nagyizee/flightlogger/Doc/Antenna/100pcs-lot-bluetooth-serial-module-with-Built-in-2-4GHz-PCB-Antennas.jpg

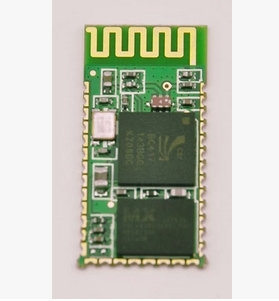
Doc/Antenna/100pcs-lot-bluetooth-serial-module-with-Built-in-2-4GHz-PCB-Antennas.jpg
