nagyizee/flightlogger/Doc/Antenna/Programming-nRF51822-RF-BM-ND02C-PCB-Antenna.jpg_350x350.jpg

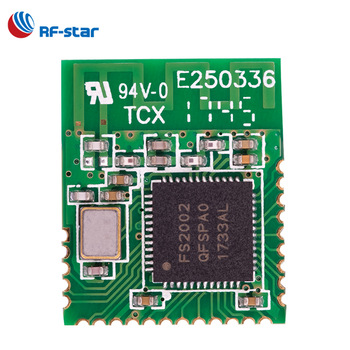
Doc/Antenna/Programming-nRF51822-RF-BM-ND02C-PCB-Antenna.jpg_350x350.jpg
