nagyizee/flightlogger/Doc/Antenna/anntennaPCBtop.PNG

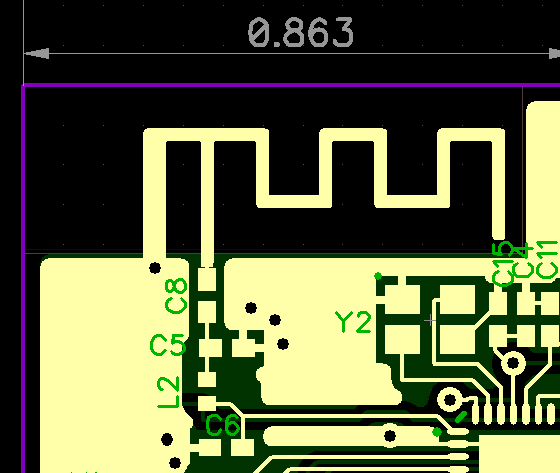
Doc/Antenna/anntennaPCBtop.PNG
