nagyizee/flightlogger/Doc/Antenna/antena_sample.jpg

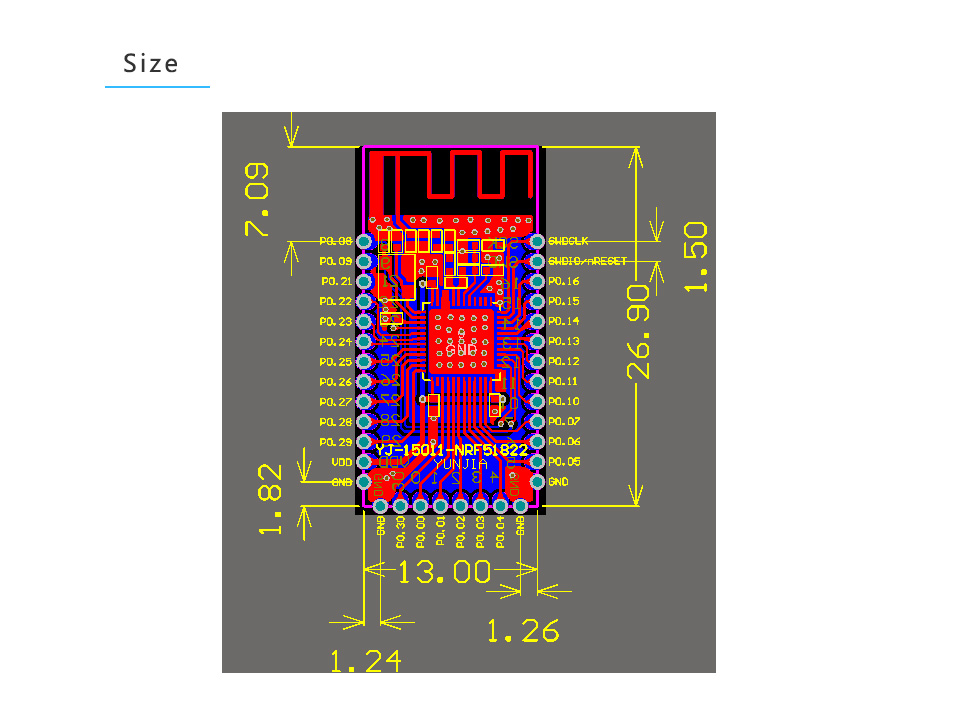
Doc/Antenna/antena_sample.jpg
