nagyizee/flightlogger/Doc/Antenna/images.png

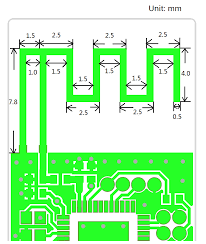
Doc/Antenna/images.png
