nagyizee/flightlogger/Doc/FlightLogger_BOM.xlsx

Designator | Comment | Part name | Description | Footprint | LibRef | Quantity | Price | Total | Location
U1 | nRF52832-QFAA-R7 | nRF52832-QFAA-R7 | ARM Cortex M4 microcontroller with 2.4GHz radio | QFN48 | nRF52832 | 1 | 27.846 | 27.846 | B1P1S15
U2 | XC9264B75DER-G | XC9264B75DER-G | 18V 0.5A step down DC-DC converter | USP-6C | XC9264 | 1 | 5.355 | 5.355 | B1P4S18 | o
U3 | MPL3115A2 | MPL3115A2 | Precision barometer sensor I2C | MPL3115A2 | MPL3115A2 | 1 | 24.871 | 24.871 | B1P2S20 | o
U4 | MMA8452Q | MMA8452Q | 3 axis accelerometer | QFN16SP | MMA8452Q | 1 | 12.257 | 12.257 | B1P2S25 | o
U5 | S25FL064LABNFV040 | S25FL064LABNFV040 | 64Mbit NOR flash | USON8 | S25FL064L | 1 | 5.831 | 5.831 | B1P3S23 | o
D23 | CDZVT2R3.0B | CDZVT2R3.0B | Zener Diode | VMN2M | D Zener | 1 | 0.7854 | 0.7854 | B1P5S21 | o
D10 | LL-S192VC-V1-2B | LL-S192VC-V1-2B | Red LED | 0603_led_red | LED | 1 | 0.5 | 0.5 | B1P7S3
D11 | IN-S63AT5G | IN-S63AT5G | Green LED | 0603_led_green | LED | 1 | 0.476 | 0.476 | B1P7S20
D20, D21, D22 | PMEG2002AESF | PMEG2002AESF | Schottky Barrier Diode | SOD962_2 | 1PS76SB10 | 3 | 1.309 | 3.927 | B1P5S20 | o
Y1 | NX2016SA-32M-EXS00A-CS06465 | NX2016SA-32M-EXS00A-CS06465 | Crystal Oscillator | Cristal_2_1.6_4pin | XTAL | 1 | 2.499 | 2.499 | B1P6S12 | o
C10, C11 | 12p |  | Capacitor | 0402_cap | CAP | 2 | 0.1 | 0.2 | B2P1S1 | o
C12, C13, C15, C21, C25, C30, C31, C40, C41, C51 | 100n |  | Capacitor | 0402_cap | CAP | 10 | 0.1 | 1 | B2P1S15 | o
C14, C32, C42 | 4u7 |  | Capacitor | 0402_cap | CAP | 3 | 0.2 | 0.6 | B2P1S21 | o
C16 | 1u |  | Capacitor | 0402_cap | CAP | 1 | 0.1 | 0.1 | B2P1S18 | o
C17 | 100p |  | Capacitor | 0402_cap | CAP | 1 | 0.1 | 0.1 | B2P1S31 | o
C18 | N/C |  | Capacitor | 0402_cap | CAP | 1 | 0 | 0 | n/a | n
C19 | 0.8p |  | Capacitor | 0402_cap | CAP | 1 | 0.5 | 0.5 | B2P1S34 | o
C20 | 1.2p |  | Capacitor | 0402_cap | CAP | 1 | 0.4 | 0.4 | B2P1S30 | o
C22 | 330p |  | Capacitor | 0402_cap | CAP | 1 | 0.4 | 0.4 | B2P1S32 | o
C23, C24, C50 | 10u | GRM155R60G106ME44J | Capacitor | 0402_cap | CAP | 3 | 0.5 | 1.5 | B2P1S28 | o
C26 | 10n | 885012205067 | Capacitor | 0402_cap | CAP | 1 | 0.1 | 0.1 | B2P1S29 | o
C27, C28 | 100u | GRM31CR61A107ME05L | Capacitor | 1206_cap | CAP | 2 | 2.9 | 5.8 | B2P1S33 | o
L1 | 3.9nH | L-07W3N9JV4T | Inductor | 0402_res | Inductor | 1 | 1.071 | 1.071 | B2P1S55 | o
L20 | 2.2uH | MAMK2520H2R2M | Inductor | 1008_Inductor | Inductor | 1 | 1 | 1 | B2P1S54 | o
R10, R11, R12 | 120 |  | Resistor | 0402_res | RES | 3 | 0.1 | 0.3 | B2P2S12 | o
R13, R14 | 1k |  | Resistor | 0402_res | RES | 2 | 0.1 | 0.2 | B2P2S17 | o
R20, R28 | 100k |  | Resistor | 0402_res | RES | 2 | 0.1 | 0.2 | B2P2S34 | o
R21 | 33k |  | Resistor | 0402_res | RES | 1 | 0.1 | 0.1 | B2P2S27 | o
R22, R24, R50 | 47k |  | Resistor | 0402_res | RES | 3 | 0.1 | 0.3 | B2P2S28 | o
R23 | 6k8 |  | Resistor | 0402_res | RES | 1 | 0.1 | 0.1 | B2P2S22 | o
R25 | 22k |  | Resistor | 0402_res | RES | 1 | 0.1 | 0.1 | B2P2S24 | o
R26 | 2R2 |  | Resistor | 0603_res | RES | 1 | 0.1 | 0.1 | B2P2S5 | o
R27, R30, R31 | 4k7 |  | Resistor | 0402_res | RES | 3 | 0.1 | 0.3 | B2P2S21 | o
R32 | 0 |  | Resistor | 0402_res | RES | 1 | 0.1 | 0.1 | B2P2S1 | o
J1, J2, J3, J4, J10, J11, J12, J13 | PAD |  | Pad | PAD_0.6x1mm | PAD | 8 | 0 | 0 | n/a
P1 | Conn3 |  | 3pin connection | HDR1X3 | conn_3pin_1 | 1 | 0 | 0 | n/a
P2 | Conn4 |  | 4pin connection | conn_4pin_1row_1mm | conn_4pin | 1 | 0 | 0 | n/a
 |  |  |  |  |  |  | Total | 98.9184
