nagyizee/flightlogger/Doc/to_get.xlsx

 |  |  |  |  |  |  | price | pcs. | total | total TVA
XC9264B75DER-G | Switching Voltage Regulators 18V DCDC Converters 0.5A Sync PWM w/AS | in.v 3 - 18V | out.v 1 - 15V | 2.2MHz | 500mA |  | 4.45 | 10 | 44.5 | 52.955 | ok
BD9G101G-TR | Switching Voltage Regulator | in. v 6 - 42V | out. v 1 - 36V | 1.5MHz | 500mA | ssop6
MLZ1608A2R2MT | Fixed Inductors 0603 2.2uH 20% | pack. 603 | 2.2uH | 500mA | 250mOhm |  | 0.42 | 50 | 21 | 24.99
MAMK2520H2R2M | Fixed Inductors 1008 2.2uH 20% | pack. 1008 | 2.2uH | 2.2A | 90mOhm |  | 0.81 | 15 | 12.15 | 14.4585 | ok
1235AS-H-6R8M | Fixed Inductors 4.5x4.7x1.8mm 6u8
AD8418BRMZ-RL | Current Sense Amplifiers 0-Drift Precision Current Sense AMP | 0 - 70V cmV | Vcc 2.7-5.5V | 20x gain | Hi/Lo sense |  | 10.55 | 5 | 52.75 | 62.7725
WSL36371L000DEA | Current Sense Resistors - SMD 3watt .001ohms .5% | 9x9mm |  |  |  |  | 12.3 | 3 | 36.9 | 43.911
BSS84P H6327 | MOSFET P-Ch -60V -170mA SOT-23-3 | 190mA | 60V DS.bkdn. | 20v Gs | 8 Ohm |  | 0.97 | 30 | 29.1 | 34.629
IN-S63AT5G | Standard LEDs - SMD True Green LED | pack. 603 | 350mcd | 3V | 5mA |  | 0.39 | 50 | 19.5 | 23.205 | ok
SS16HE | Schottky Diodes & Rectifiers 60V 1A Schottky Barrier Rectifier | If 1A | Vf 0.4-06V | Vr 60V |  |  | 0.34 | 20 | 6.8 | 8.092
PMEG2002AESF,315 | Schottky Diodes & Rectifiers 20 V, 0.2 A low VF MEGA Schottky | If 200mA | Vf 0.24V | Vr 20V | 10pF | ultra small | 0.98 | 20 | 19.6 | 23.324 | ok
CDZVT2R3.0B | Zener diode 3.0V 1.4x0.5mm |  |  |  |  |  | 0.28 | 100 | 28 | 33.32 | ok
NX2016SA-32M-EXS00A-CS06465 | 32MHz 10ppM prec. / 30ppM stab. 2x1.6x0.5mm | 32MHz | 10pF |  |  |  | 2.04 | 10 | 20.4 | 24.276 | ok
GRM31CR61A107ME05L | 100uF 10V ceramic capacitor | 100uF | 10V | 1206 |  |  | 2.37 | 12 | 28.44 | 33.8436 | ok
GRM155R60G106ME44J | 10uF 402 4V 20% | 10uF | 4V | 402 |  |  | 0.41 | 50 | 20.5 | 24.395 | ok
nRF52832-QFAA-R7 | BLE uc |  |  |  |  |  | 23.4 | 4 | 93.6 | 111.384 | ok
mpl3115A2 | press. sens |  |  |  |  |  | 20.9 | 4 | 83.6 | 99.484 | ok
MMA8452QR1 | accelero |  |  |  |  |  | 10.3 | 5 | 51.5 | 61.285 | ok
S25FL064LABNFV040 | ExtFlash |  |  |  |  |  | 4.9 | 5 | 24.5 | 29.155 | ok
0900-4-15-20-75-14-11-0 | 6mm fi2mm round pogo pin |  |  |  |  |  | 1.74 | 10 | 17.4 | 20.706 | ok
50V caps. 22uF / 10uF / 1uF |  |  |  |  |  |  |  |  | 0 | 0
GCM1555C1H331JA16D |  | 330pF | 50V | 402 |  |  | 0.3 | 20 | 6 | 7.14 | ok
885012205067 |  | 10nF | 50V | 402 |  |  | 0.063 | 100 | 6.3 | 7.497 | ok
AC0402JRNPO9BN101 |  | 100pF | 50V | 402 |  |  | 0.076 | 100 | 7.6 | 9.044 | ok
L-07W3N9JV4T |  | 3.9nH | 11GHz 5% | 402 |  |  | 0.84 | 10 | 8.4 | 9.996 | ok
GJM1555C1HR80DB01J |  | 0.8pF | 50V | 402 |  |  | 0.34 | 10 | 3.4 | 4.046 | ok
GJM1555C1H1R2CB01D |  | 1.2pF | 50V | 402 |  |  | 0.31 | 10 | 3.1 | 3.689 | ok
 |  |  |  |  |  |  |  |  | TOTAL: | 767.5976
