nagyizee/flightlogger/CAD/prog_fixture/prog_fixture.3mf

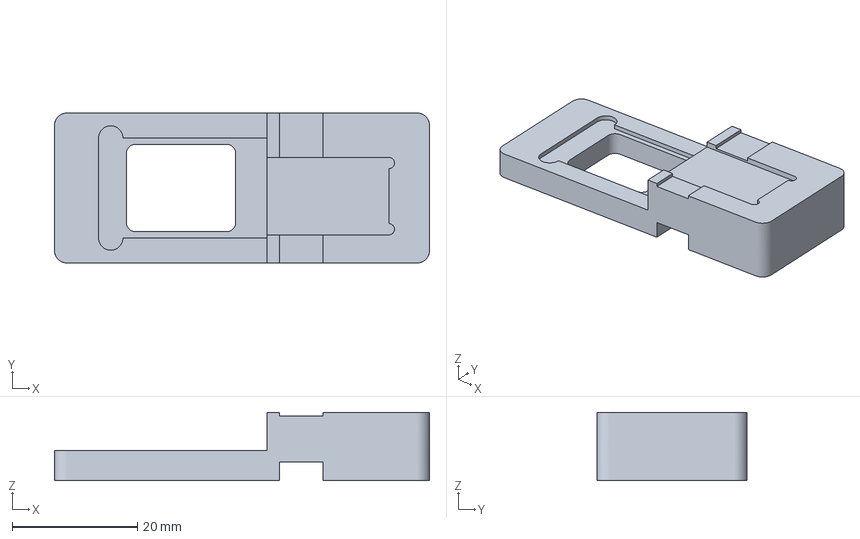
[picture p6: CAD file, 2020-03-01]
CAD/prog_fixture/prog_fixture.3mf
60.0 x 24.0 x 10.9 mm
