nagyizee/flightlogger/(list of files, cad)

Other CAD files:
CAD/prog_fixture/prog_fixture.3dm
CAD/prog_fixture/prog_fixture.stl
