nagyizee/flightlogger/Electronics/design/FlightLogger.PcbDoc.htm

Reporting Options

# File in Newer Format

Date | : | 2020-01-24
Time | : | 18:30:27
Filename | : | C:\Users\nagyizee\Google Drive\Projects\My_Projects\FlightLogger\Electronics\design\FlightLogger.PcbDoc

Version | Warning
Release 15 | CAUTION - Support of separate solder masks for top & bottom of pads added.
Release 15.1 | CAUTION - Support Multi-line PCB Text added.
Release 16.0 | CAUTION - Pad/Via hole size tolerance value added.
Release 17.0 | CAUTION - Component parameters added.
Release 17.0 | CAUTION - Supports of backdrilling

This file was generated by a later version of the software
