nagyizee/flightlogger/Electronics/simulations/extvoltmonitor.asc

C1: cap; 100n
R1: res; 47k
R2: res; 6k8
V1: voltage; 25.2; AC 5
Named nets: 0
.ac oct 10 10 2k
