nagyizee/flightlogger/Electronics/simulations/intvoltmonitor.asc

C1: cap; 10n
R1: res; 47k
R2: res; 22k
V1: voltage; PULSE(0 10 100ms 1us 1us 200ms 400ms 2); AC 0
Named nets: 0
.tran 1 startup
