nagyizee/flightlogger/Electronics/simulations/pwrfault.asc

C1: cap; 100µ
D1: diode
Q1: npn; BC847A
Q2: npn; BC847A
R1: res; 37
R2: res; 10
V1: voltage; PULSE(0 5 0 1us 1us 200ms 400ms 2); AC 0
V2: voltage; 3
Named nets: 0
.tran 1 startup
constant 60mA
