nagyizee/flightlogger/Electronics/simulations/vccfilter.asc

B1: bv; V=RAND(1000000*time)
C1: cap; 4µ7
C2: cap; 100n
L1: ind; 2µ2; Rser=250m
R1: res; 2k
R2: res; 250m
V1: voltage; 2.5; AC 0
Named nets: 0
.tran 2m startup
