nagyizee/flightlogger/Electronics/design/supply_exp.asc

C1: cap; 1µ
C2: cap; 100µ
I1: current; 1m; load
R1: res; 100
S1: sw
V1: voltage; 3; Rser=1
V2: voltage; PULSE(0 5 0.5 0.1u 0.1u 1.5 6 2)
Named nets: 0
.tran 0 6 0 0.1m
.model SW SW(Ron=10 Roff=100Meg Vt=0.5 Vh=-0.4)
