nagyizee/flightlogger/(list of files, drawings)

Other design files:
Electronics/design/FlightLogger.PcbDoc
Electronics/design/FlightLogger.PrjPcb
Electronics/design/FlightLogger.SchDoc
