nagyizee/flightlogger/Software/LoggerUnit/Sources/ApplicationRT/RtAppSensor.h

#ifndef	_RTAPPSENSOR_H
#define _RTAPPSENSOR_H
/**
 *
 *
 *
 */

/*--------------------------------------------------
 * 		    		Includes
 *--------------------------------------------------*/

#include "base.h"

/*--------------------------------------------------
 * 		    		Defines
 *--------------------------------------------------*/


/*--------------------------------------------------
 *   		  	 	Functions
 *--------------------------------------------------*/

void RtAppSensor_Main(void);

#endif
