nagyizee/flightlogger/Software/LoggerUnit/Sources/ApplicationRT/RtAppComm.h

#ifndef	_RTAPPCOMM_H
#define _RTAPPCOMM_H
/**
 *
 *
 *
 */

/*--------------------------------------------------
 * 		    		Includes
 *--------------------------------------------------*/

#include "base.h"

/*--------------------------------------------------
 * 		    		Defines
 *--------------------------------------------------*/


/*--------------------------------------------------
 *   		  	 	Functions
 *--------------------------------------------------*/

void RtAppComm_Main(void);

#endif
