nagyizee/flightlogger/Software/LoggerUnit/Sources/ApplicationRT/RtAppPack.h

#ifndef	_RTAPPPACK_H
#define _RTAPPPACK_H
/**
 *
 *
 *
 */

/*--------------------------------------------------
 * 		    		Includes
 *--------------------------------------------------*/

#include "base.h"

/*--------------------------------------------------
 * 		    		Defines
 *--------------------------------------------------*/


/*--------------------------------------------------
 *   		  	 	Functions
 *--------------------------------------------------*/

void RtAppPack_Main(void);

#endif
