nagyizee/flightlogger/Software/LoggerUnit/Sources/HAL/I2c/HALI2c_Cfg.h

#ifndef _HALI2C_CFG_H
#define _HALI2C_CFG_H

/*--------------------------------------------------
 *                              Includes
 *--------------------------------------------------*/


/*--------------------------------------------------
                                Type definitions
 *--------------------------------------------------*/


/*--------------------------------------------------
                                Defines
 *--------------------------------------------------*/

/* number of channels */
#define HALI2C_CH_NR                   (2u)
/* channel indexes */
#define HALI2C_CHANNEL_BAROMETER       (0u)
#define HALI2C_CHANNEL_ACCELERO        (1u)

#define HALI2C_CHADDR_BAROMETER        (0x60)
#define HALI2C_CHADDR_ACCELERO         (0x1C)

/*--------------------------------------------------
 *                              Exported interfaces
 *--------------------------------------------------*/

#endif
