nagyizee/flightlogger/Software/LoggerUnit/Sources/System/Os/Os_Rt.h

#ifndef	_OS_RT_H
#define _OS_RT_H
/**
 *
 *
 *
 */

/*--------------------------------------------------
 * 		    		Includes
 *--------------------------------------------------*/

#include "base.h"

/*--------------------------------------------------
 * 		    		Defines
 *--------------------------------------------------*/

#define OS_TICKS_PER_US						(2)								/* timer granularity set to 2MHz  - NOTE: synchronize it with the OsSys prescaler
 	 	 	 	 	 	 	 	 	 	 	 	 	 	 	 	 	 	 	   - Os time_ctr maximum reach: 3 x 2^64 us = 1.75M years */

#define OS_TIME2TICK(timeUs)				(timeUs * OS_TICKS_PER_US)		/* convert time in us -> timer ticks */
#define OS_TASK_TOTAL_CYCLE					(OS_TIME2TICK(5000))			/* cycle time to complete the task list */

#define OSRT_TASK_LIST_LENGTH				(10)

/*--------------------------------------------------
 * 		    		 Types
 *--------------------------------------------------*/

typedef void (*tOsTaskItem)(void);
typedef void (*tOsTaskBgndItem)(uint32 reason);

typedef struct
{
	tOsTaskItem taskItem;
	uint32		timeStamp;
} tOsSchedulerElement;

/* RealTime task list */
extern tOsSchedulerElement gOsRt_TaskList[];
/* Background task */
extern tOsTaskBgndItem gOsRt_BgndTask;

/*--------------------------------------------------
 *   		  	 	Functions
 *--------------------------------------------------*/



#endif
