nagyizee/flightlogger/Software/OsExperiment/Sources/Drivers/Example/exampleDrv.h

#ifndef	_EXAMPLEDRV_H
#define _EXAMPLEDRV_H
/**
 *
 *
 *
 */

/*--------------------------------------------------
 * 		    		Includes
 *--------------------------------------------------*/


/*--------------------------------------------------
 * 		    		Defines
 *--------------------------------------------------*/


/*--------------------------------------------------
 *   		  	 	Functions
 *--------------------------------------------------*/

/* Init the driver */
void ExampleDrv_Init(void);


#endif
