nagyizee/flightlogger/(commit log)

2019-09-05 - added empty PCB design - detailing hw. design
    [FlightLogger.PrjPcb, FlightLogger.SchDoc, docs.xlsx]
2020-02-11 - bulk and rttask period run with sleep - TESTED for bulk and rttask wakeup
    [FlightLogger.PrjPcb, FlightLogger.SchDoc, docs.xlsx]
2020-02-23 archive the STM32
2020-03-01 docs update
    [FlightLogger_BOM.xlsx, docs.xlsx, to_get.xlsx]
2020-03-01 updated electronix stuff
    [FlightLogger.GBL, FlightLogger.GBO, FlightLogger.GBP, FlightLogger.GBS, FlightLogger.GTL, FlightLogger.GTO, FlightLogger.GTP, FlightLogger.GTS]
2020-03-01 added debugging fixture CAD
    [prog_fixture.3dm, prog_fixture.3mf, prog_fixture.stl]
2020-03-02 Antenna design documentation reorganized
2020-03-05 SPI driver interface definition, first version dummy code
2020-03-05 Working hours separated from HW related info, format changed to Word97 for compatibility with OpenOffice saving
    [workhours.xls]
2020-03-05 created interfaces for barometer and i2c drivers
2020-03-05 added hours
    [docs.xlsx]
2020-03-10 I2C write and status is working
2020-03-11 cypress Flash driver interface definition first version
2020-03-11 added working hours i2c
    [docs.xlsx]
2020-03-11 - finished first crude version of the i2c driver - basic test are done
    [docs.xlsx]
2020-03-12 CypFlash, SPI interfaces, Os integration updated
    [workhours.xls]
2020-03-13 CypFlash test code rearranged
    [workhours.xls]
2020-03-14 working on SPI
2020-03-14 working on SPI driver
2020-03-15 SPI driver is working (hopefully well) - tested for multibuffer read/writes - seems ok
2020-03-15 fixed small data amount SPI crashes (because of faulty restarts)
    [HALSpi.c]
2020-03-15 CypFlash initialization
    [workhours.xls]
2020-03-16 CypFlash Reinitialization from Comm error implemented
    [workhours.xls]
2020-03-16 Cypflash Read functionality
    [workhours.xls]
2020-03-16 CypFlas Write and WritePage
    [workhours.xls]
2020-03-16 CypFlash Erase Sector, Erase Block, CheckStatus functionality
    [workhours.xls]
2020-03-16 CypFlash ChipErase implemented, review corrections
    [workhours.xls]
2020-03-17 FEE doc, app initial structure proposal
    [workhours.xls]
2020-03-17 Application modules added
    [workhours.xls]
2020-03-17 Flash memory layout first version
    [Flash_Layout.xls, workhours.xls]
2020-03-17 Flash memory layout updated
    [Flash_Layout.xls]
2020-03-17 RtAppData first version
    [Flash_Layout.xls, workhours.xls]
2020-03-18 RtAppData Init implemented
    [Flash_Layout.xls, NVM_Layout.xls, workhours.xls]
2020-03-18 enable interrupts after HAL init
2020-03-20 Nvm generic module first version
    [workhours.xls]
2020-03-20 Revert "Merge branch 'NVM'"
    This reverts commit 16c860e5b2f95782bc75475eb01c4ecba99a8cae, reversing
    changes made to 272997ecdd311ca0486f65aad67b549cc329b76e.
    [workhours.xls]
2020-03-23 corrections after merging
    [workhours.xls]
2020-03-23 Bugfix - Recover timing too tight if flash main function runs in a while loop
    [CypFlash.c]
2020-03-23 Timeout enhancement in CypFlash driver calling from different timebases or while loops
    [workhours.xls]
2020-03-23 added input pin read
2020-03-23 Nvm Insert write buffer to keep block data consistency with header
    [workhours.xls]
2020-03-30 RtAppMeasurement module added
    [workhours.xls]
2020-04-03 - fixed nxpbaro sensor read issues - conversions are still bad - upcoming fix
    [docs.xlsx]
2020-04-05 NVM Block created for AppData tracking
    [workhours.xls]
2020-04-19 CRC8 study and implementation of different polynomials
    [workhours.xls]
2020-04-23 Implementation of the Nxp accelerometer driver
2020-04-23 updated work hours
    [docs.xlsx]
2020-04-23 update wh
    [docs.xlsx]
2020-06-08 fixed value conversion issues
    [NxpBaro.c]
